Lancaster-Rocketry-Society/rocket-core/flight-computer/rocket1-avionics/test/out/nominal_sim.csv

t_s | state | true_alt_m | true_vel_ms | est_agl_m | est_vspd_ms | accel_ms2
0.00 | CAL | 0.000 | 0.000 | 0.000 | 0.000 | 9.574
0.02 | CAL | 0.000 | 0.000 | -0.042 | -0.656 | 11.010
0.04 | CAL | 0.000 | 0.000 | -0.166 | -2.452 | 9.095
0.06 | CAL | 0.000 | 0.000 | -0.317 | -4.270 | 9.574
0.08 | CAL | 0.000 | 0.000 | -0.440 | -5.400 | 10.053
0.10 | CAL | 0.000 | 0.000 | -0.308 | -2.487 | 10.053
0.12 | CAL | 0.000 | 0.000 | -0.124 | 0.328 | 8.617
0.14 | CAL | 0.000 | 0.000 | -0.123 | 0.001 | 9.574
0.16 | CAL | 0.000 | 0.000 | -0.152 | -0.627 | 8.138
0.18 | CAL | 0.000 | 0.000 | -0.030 | 1.448 | 8.617
0.20 | CAL | 0.000 | 0.000 | -0.091 | -0.464 | 9.574
0.22 | CAL | 0.000 | 0.000 | -0.088 | -0.116 | 9.574
0.24 | CAL | 0.000 | 0.000 | -0.030 | 0.711 | 10.053
0.26 | CAL | 0.000 | 0.000 | 0.115 | 2.788 | 11.010
0.28 | CAL | 0.000 | 0.000 | 0.089 | 1.956 | 8.617
0.30 | CAL | 0.000 | 0.000 | -0.024 | -0.115 | 9.574
0.32 | CAL | 0.000 | 0.000 | -0.098 | -1.253 | 9.574
0.34 | CAL | 0.000 | 0.000 | -0.090 | -0.999 | 11.489
0.36 | CAL | 0.000 | 0.000 | -0.067 | -0.570 | 9.095
0.38 | CAL | 0.000 | 0.000 | -0.106 | -1.100 | 9.574
0.40 | CAL | 0.000 | 0.000 | -0.200 | -2.542 | 9.574
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
