Lancaster-Rocketry-Society/rocket-core/flight-computer/rocket1-avionics/test/out/openrocket_compare.csv

time_s | altitude_m | vertical_velocity_ms | accel_magnitude_ms2
0.0 | 0.35 | 2.74 | 70.85
0.01 | 0.42 | 3.48 | 71.33
0.02 | 0.5 | 4.18 | 71.33
0.03 | 0.57 | 4.47 | 71.33
0.04 | 0.63 | 4.82 | 70.37
0.05 | 0.68 | 4.86 | 68.93
0.06 | 0.83 | 6.34 | 69.41
0.07 | 0.94 | 7.04 | 69.89
0.08 | 1.05 | 7.6 | 68.93
0.09 | 1.13 | 7.68 | 70.37
0.1 | 1.07 | 5.58 | 68.45
0.11 | 1.02 | 4.04 | 68.45
0.12 | 1.15 | 5.38 | 69.89
0.13 | 1.25 | 6.03 | 70.37
0.14 | 1.33 | 6.36 | 70.37
0.15 | 1.39 | 6.33 | 69.41
0.16 | 1.61 | 8.68 | 68.93
0.17 | 1.78 | 9.85 | 70.37
0.18 | 2.01 | 11.83 | 70.85
0.19 | 2.18 | 12.64 | 70.85
0.2 | 2.39 | 13.9 | 70.85
0.21 | 2.55 | 14.17 | 70.37
0.22 | 2.84 | 16.39 | 70.85
0.23 | 3.05 | 17.18 | 70.37
0.24 | 3.19 | 16.6 | 68.45
0.25 | 3.29 | 15.61 | 70.85
0.26 | 3.46 | 15.89 | 70.37
0.27 | 3.59 | 15.48 | 69.41
0.28 | 3.85 | 17.07 | 69.41
0.29 | 4.05 | 17.45 | 70.37
0.3 | 4.24 | 17.68 | 69.89
0.31 | 4.38 | 17.16 | 69.89
0.32 | 4.67 | 18.9 | 69.89
0.33 | 4.88 | 19.31 | 70.37
0.34 | 5.2 | 21.1 | 70.37
0.35 | 5.43 | 21.45 | 69.89
0.36 | 5.83 | 24.28 | 68.93
0.37 | 6.14 | 25.17 | 69.89
0.38 | 6.59 | 28.21 | 71.33
0.39 | 6.93 | 29.09 | 68.45
0.4 | 7.07 | 26.78 | 68.93
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
