Lancaster-Rocketry-Society/rocket-core/flight-computer/rocket1-avionics/test/out/flight_analysis.png

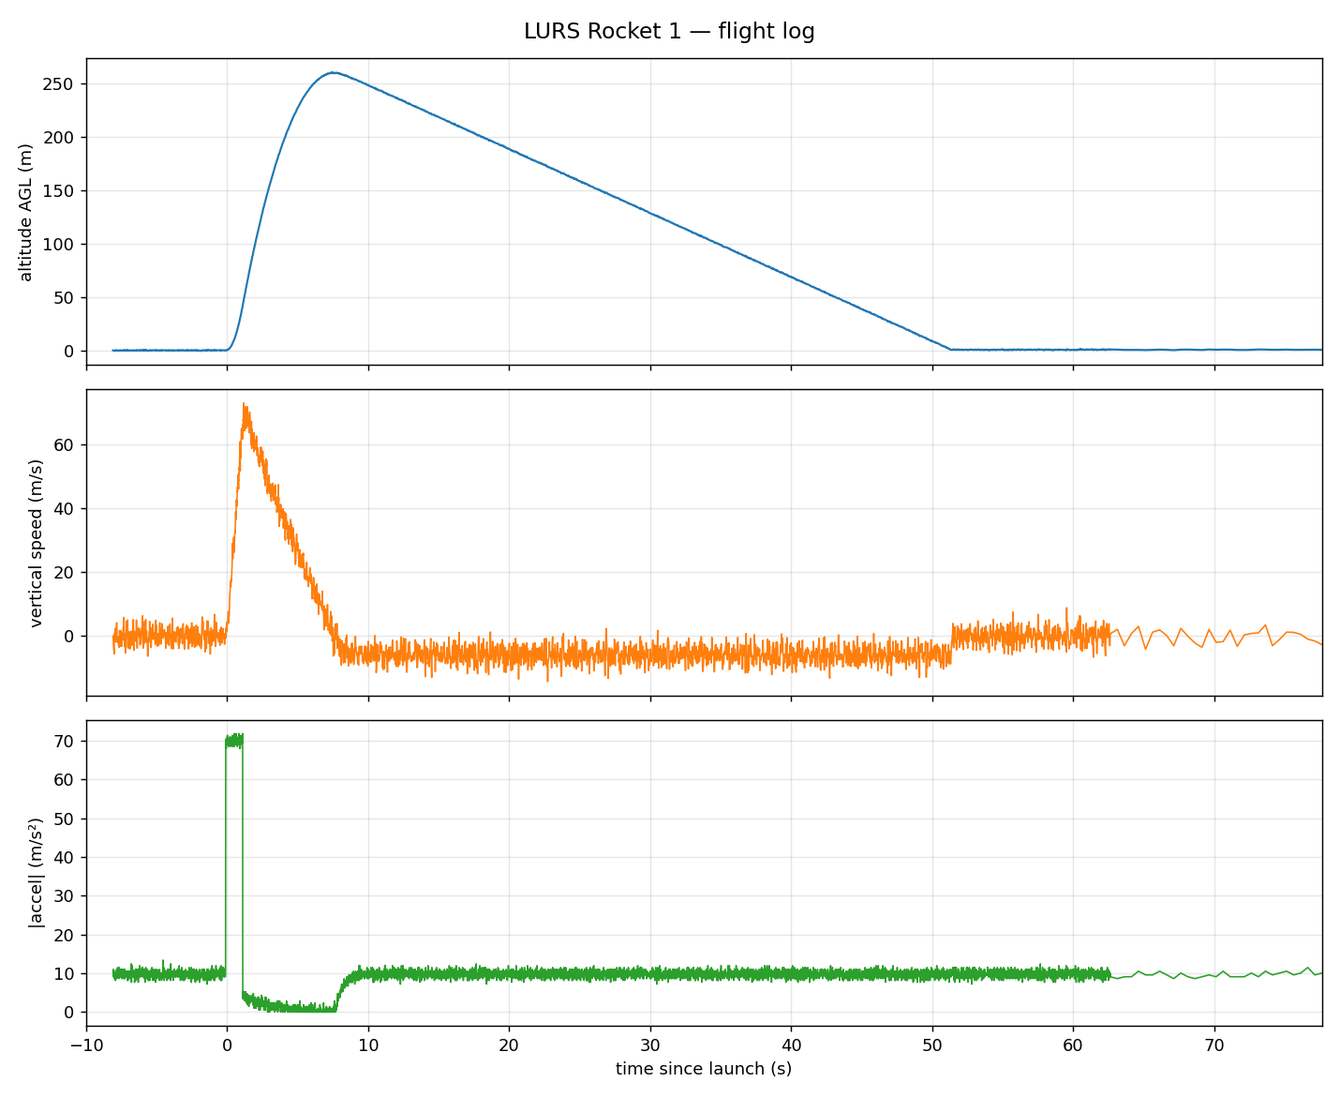
flight-computer/rocket1-avionics/test/out/flight_analysis.png
