Lancaster-Rocketry-Society/rocket-core/flight-computer/rocket1-avionics/test/out/verification_nominal.png

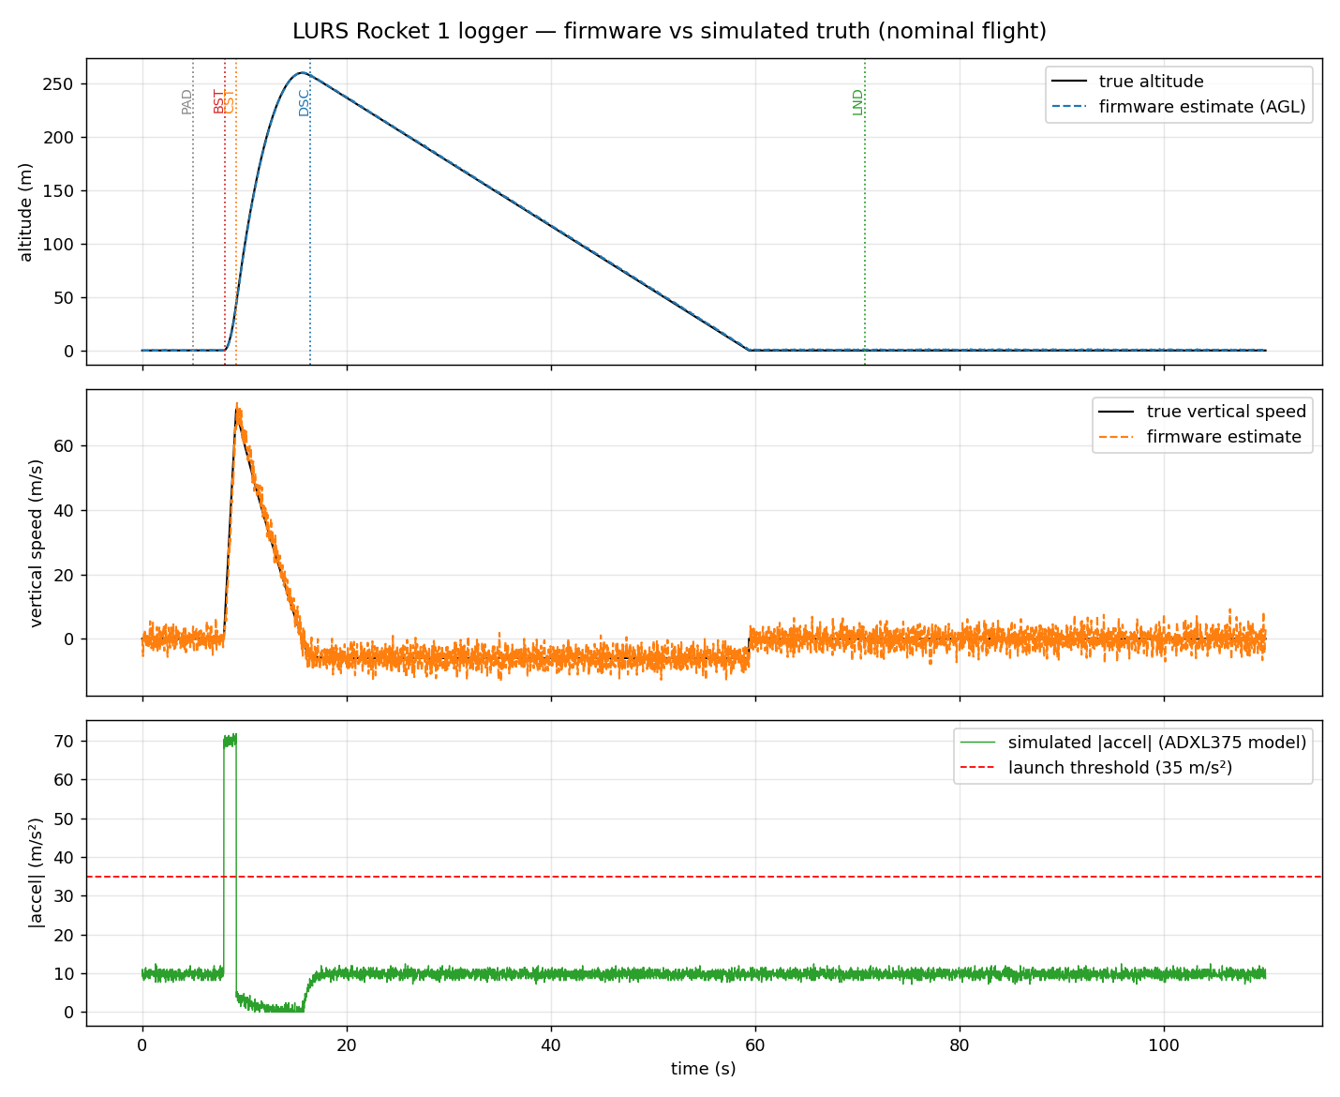
flight-computer/rocket1-avionics/test/out/verification_nominal.png
